Kvisby/ZPD_Kristaps_Bukss/Maketesanas_plate/20240205_205620.jpg

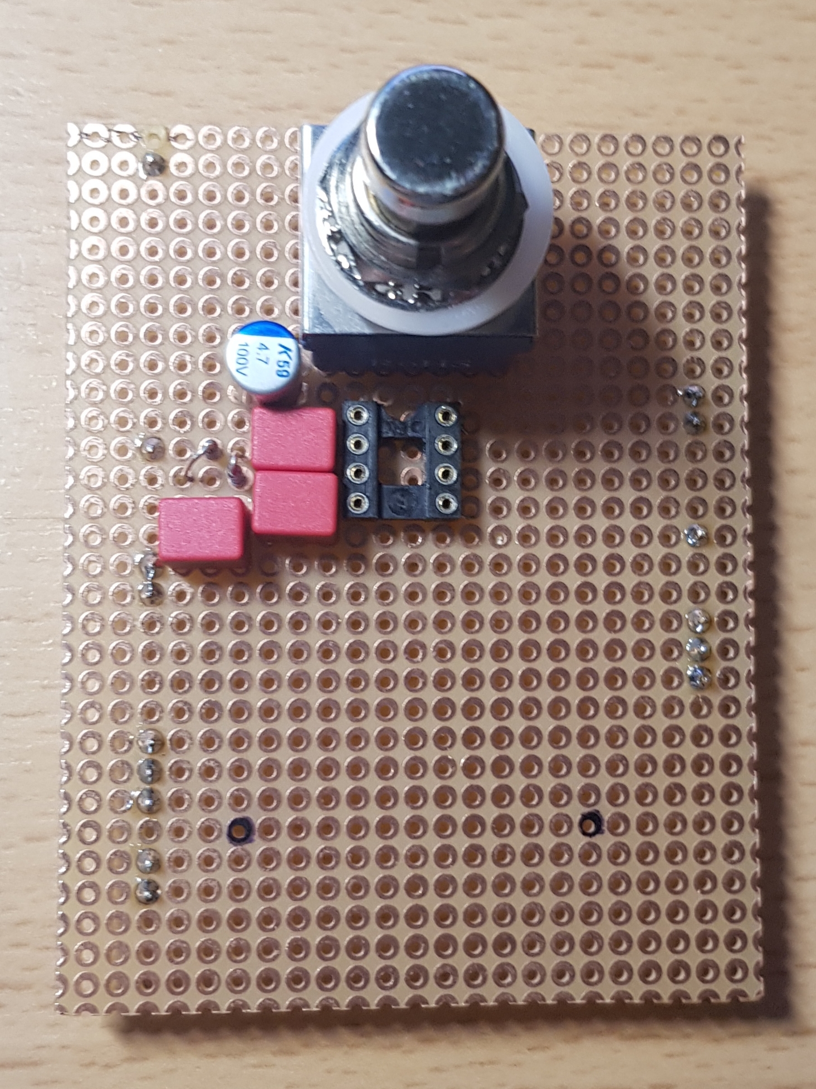
Maketesanas_plate/20240205_205620.jpg
