Kvisby/ZPD_Kristaps_Bukss/Maketesanas_plate/20240205_205634.jpg

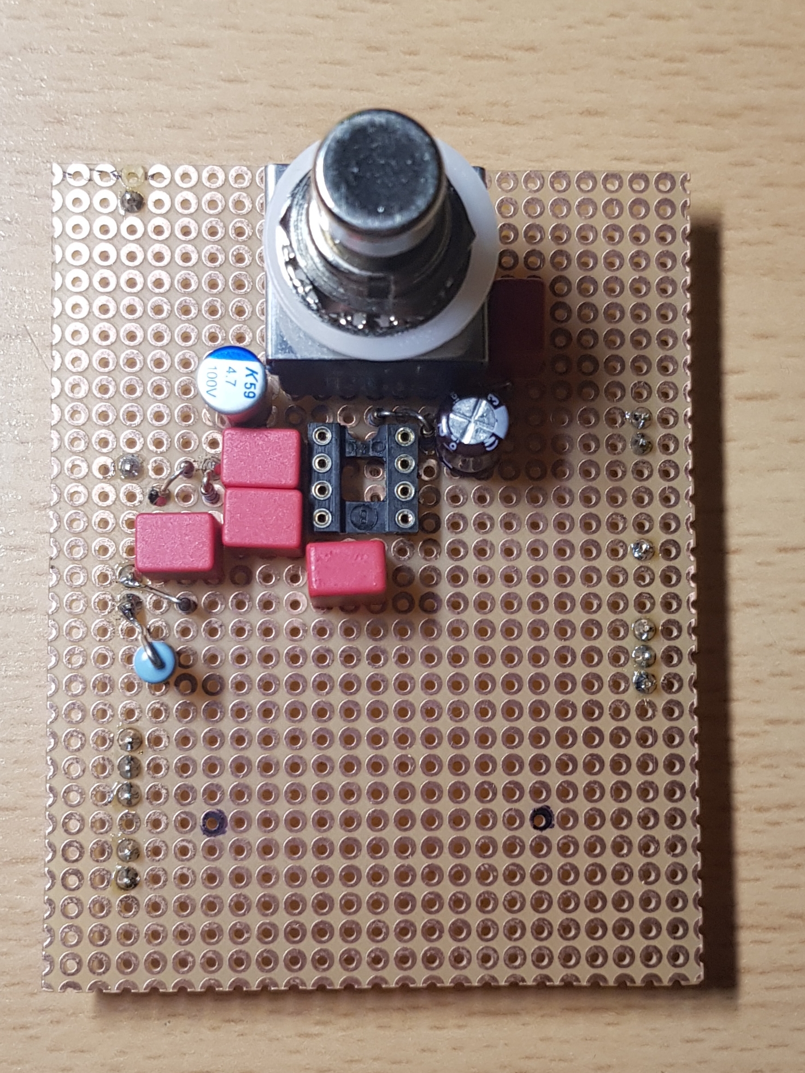
Maketesanas_plate/20240205_205634.jpg
