Kvisby/ZPD_Kristaps_Bukss/README.md

# ZPD_Kristaps_Bukss
Izmantotie/svarīgie faili zpd izveidei (Drukatas_plates_shema_ZPD_KB.json un Grafiskas_plates_shema_ZPD_KB faili jāatver caur "EasyEDA" programmu)
