Kvisby/ZPD_Kristaps_Bukss/Komponentes/1MΩ.jpg

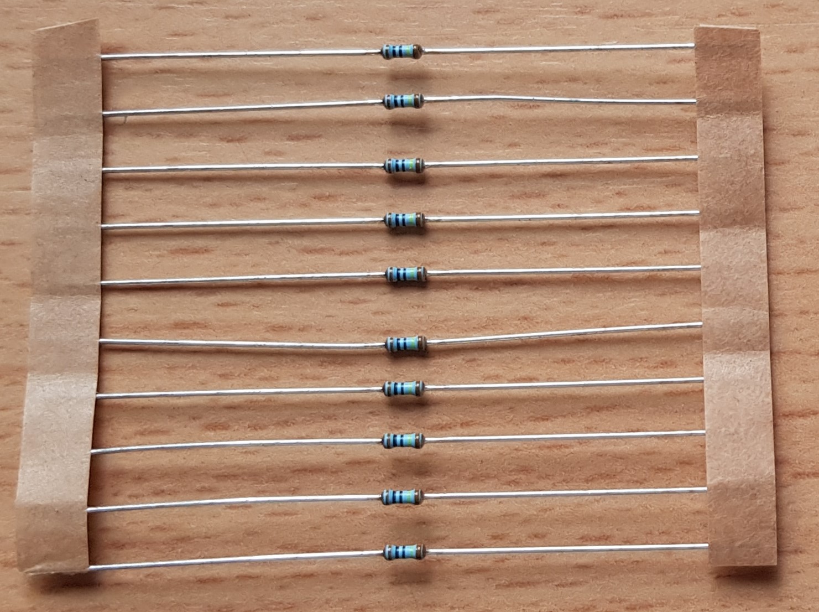
Komponentes/1MΩ.jpg
