Kvisby/ZPD_Kristaps_Bukss/Komponentes/2MΩ.jpg

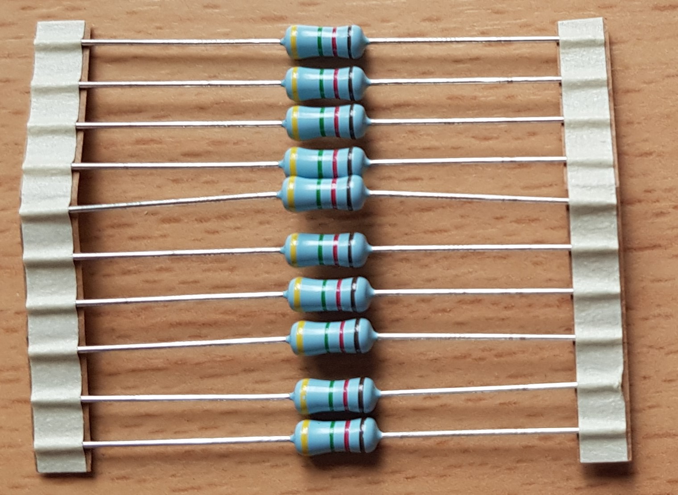
Komponentes/2MΩ.jpg
