Kvisby/ZPD_Kristaps_Bukss/Komponentes/4.7uF.jpg

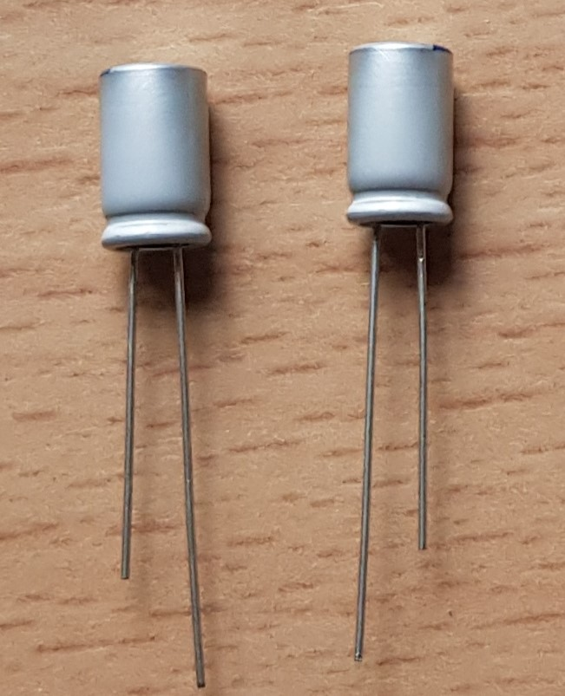
Komponentes/4.7uF.jpg
