Kvisby/ZPD_Kristaps_Bukss/Komponentes/6.8nF.jpg

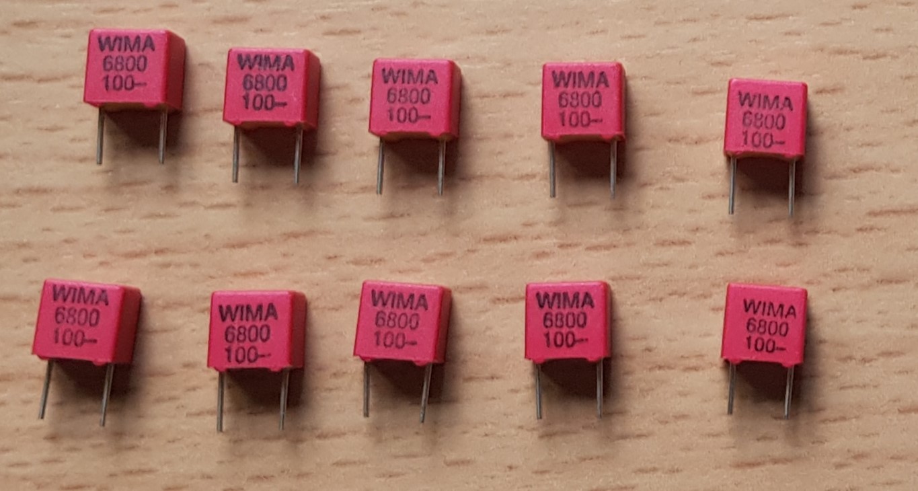
Komponentes/6.8nF.jpg
