Kvisby/ZPD_Kristaps_Bukss/Komponentes/7kΩ.jpg

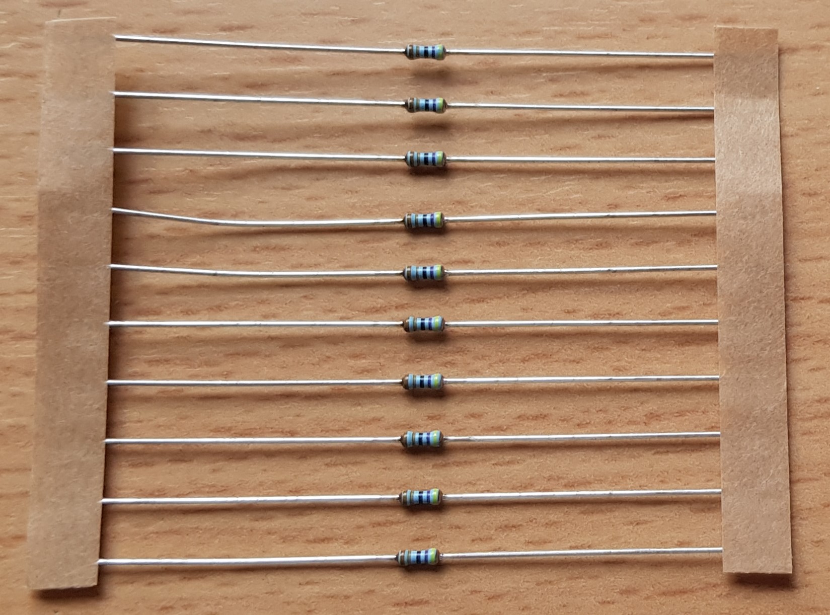
Komponentes/7kΩ.jpg
