Kvisby/ZPD_Kristaps_Bukss/Komponentes/100kΩ.jpg

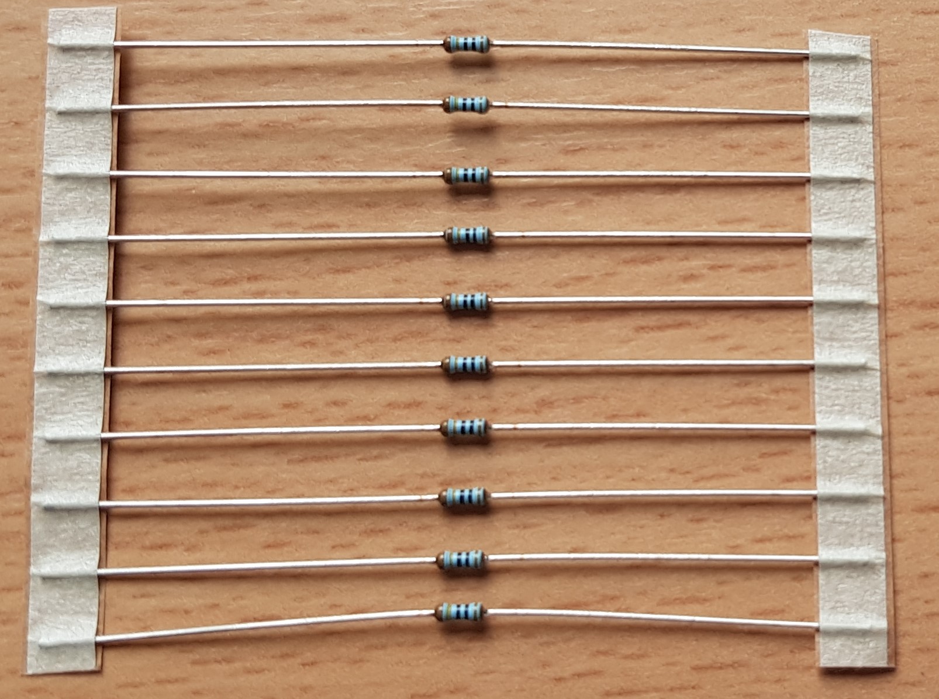
Komponentes/100kΩ.jpg
