Kvisby/ZPD_Kristaps_Bukss/Komponentes/100nF.jpg

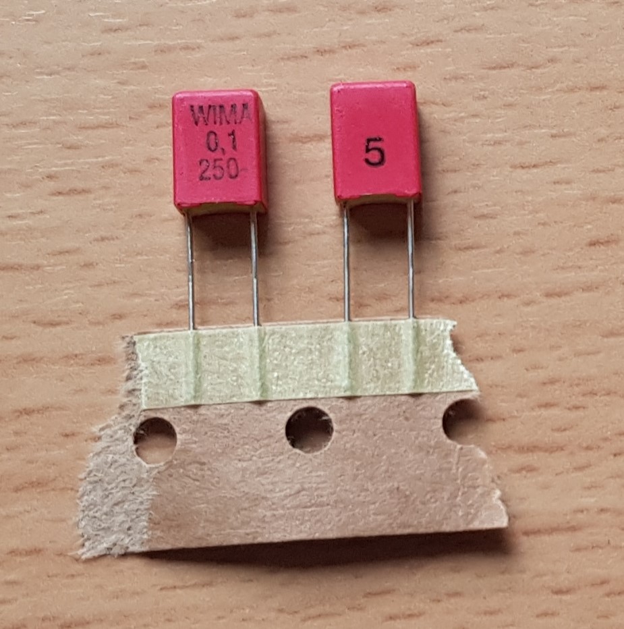
Komponentes/100nF.jpg
