Kvisby/ZPD_Kristaps_Bukss/Komponentes/20240204_141854.jpg

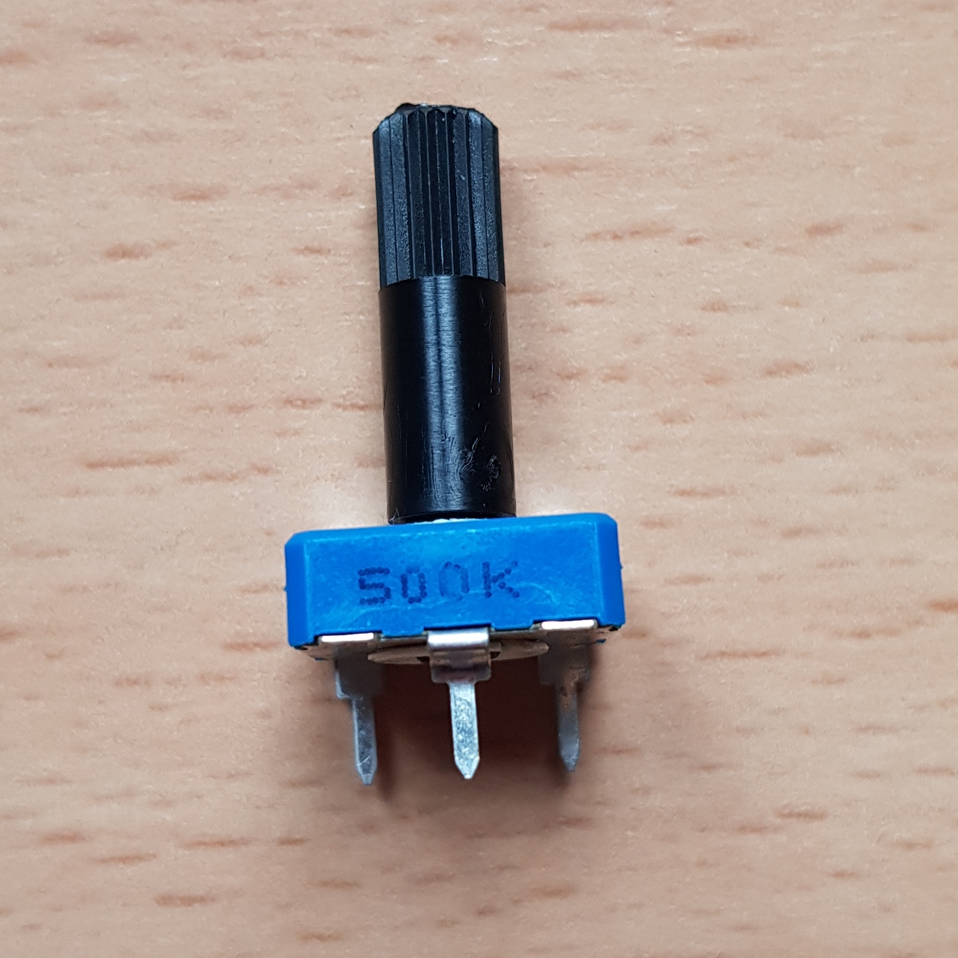
Komponentes/20240204_141854.jpg
