Kvisby/ZPD_Kristaps_Bukss/Komponentes/20240204_141914.jpg

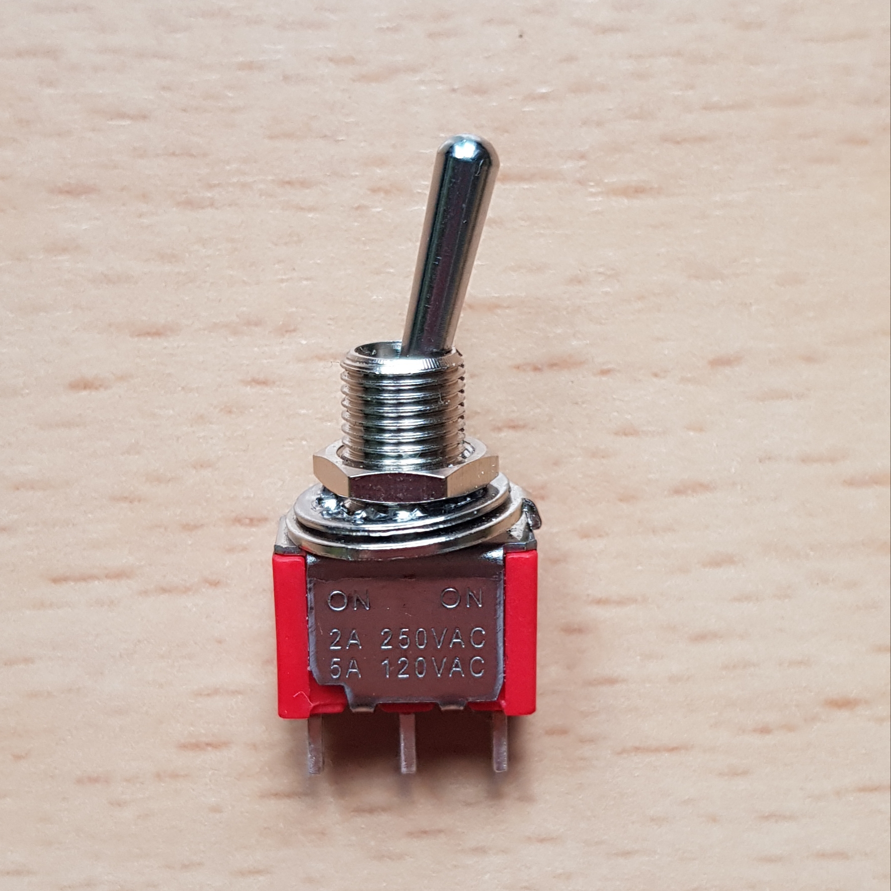
Komponentes/20240204_141914.jpg
