Kvisby/ZPD_Kristaps_Bukss/Komponentes/20240204_141937.jpg

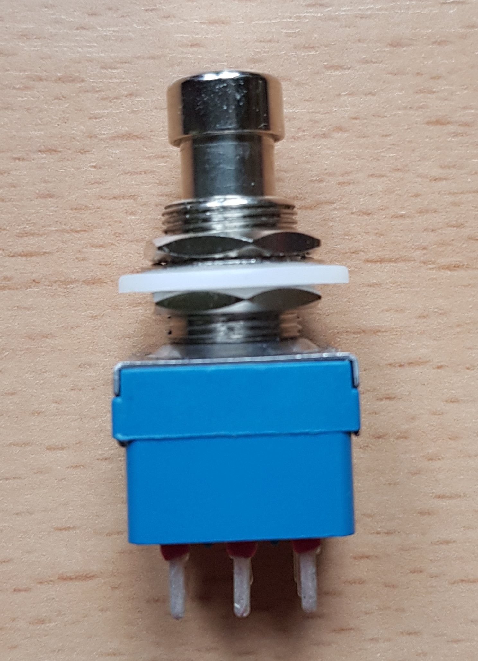
Komponentes/20240204_141937.jpg
