Kvisby/ZPD_Kristaps_Bukss/Komponentes/20240204_142005.jpg

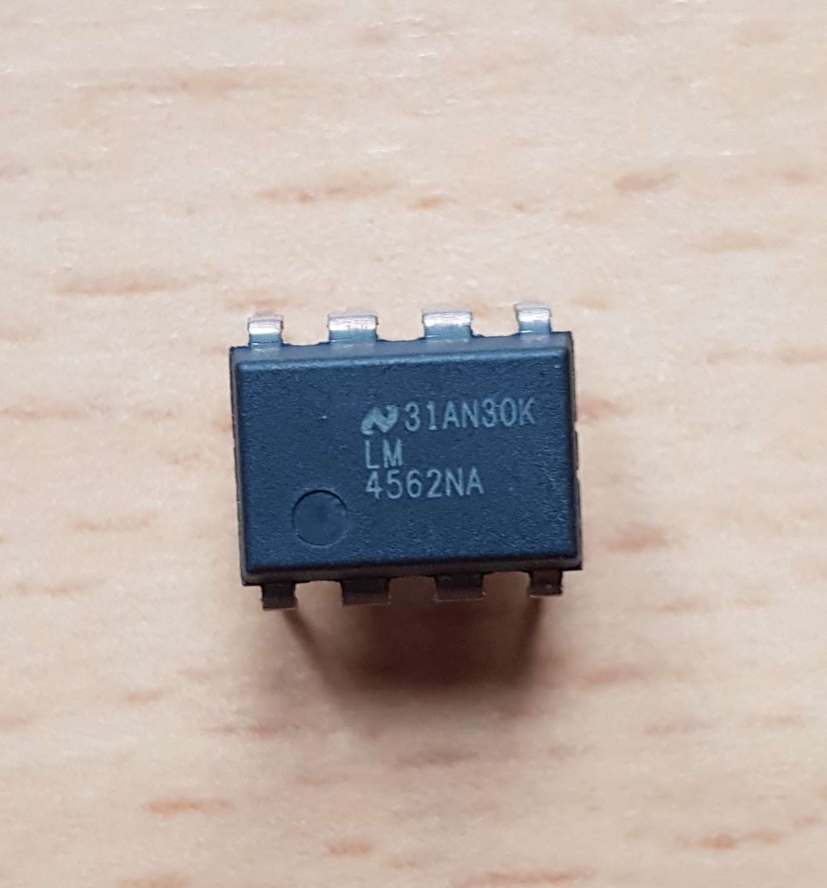
Komponentes/20240204_142005.jpg
