Kvisby/ZPD_Kristaps_Bukss/Komponentes/20240204_142020.jpg

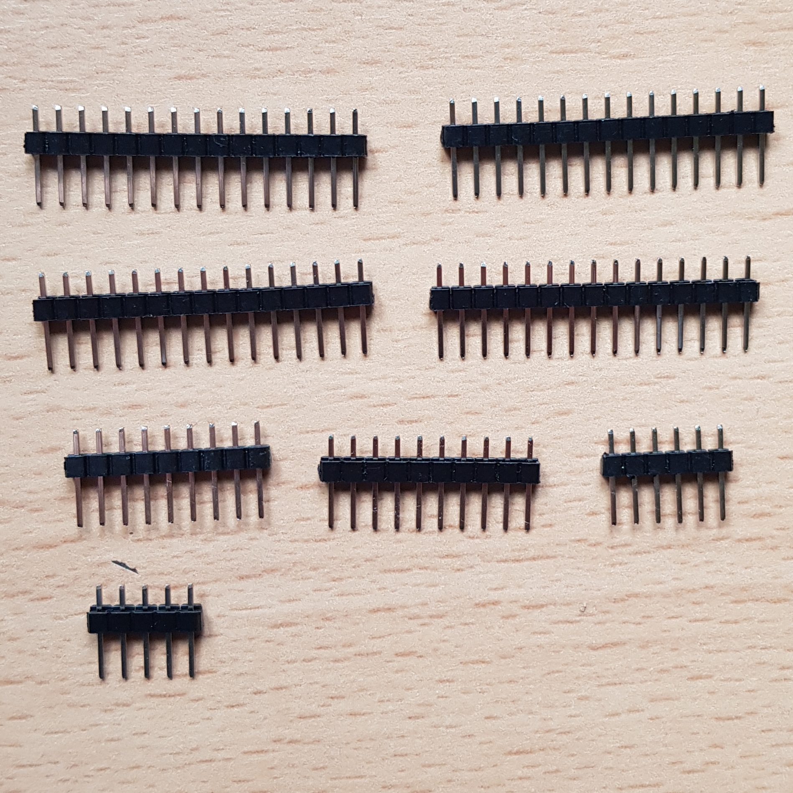
Komponentes/20240204_142020.jpg
