Kvisby/ZPD_Kristaps_Bukss/Komponentes/20240204_142149.jpg

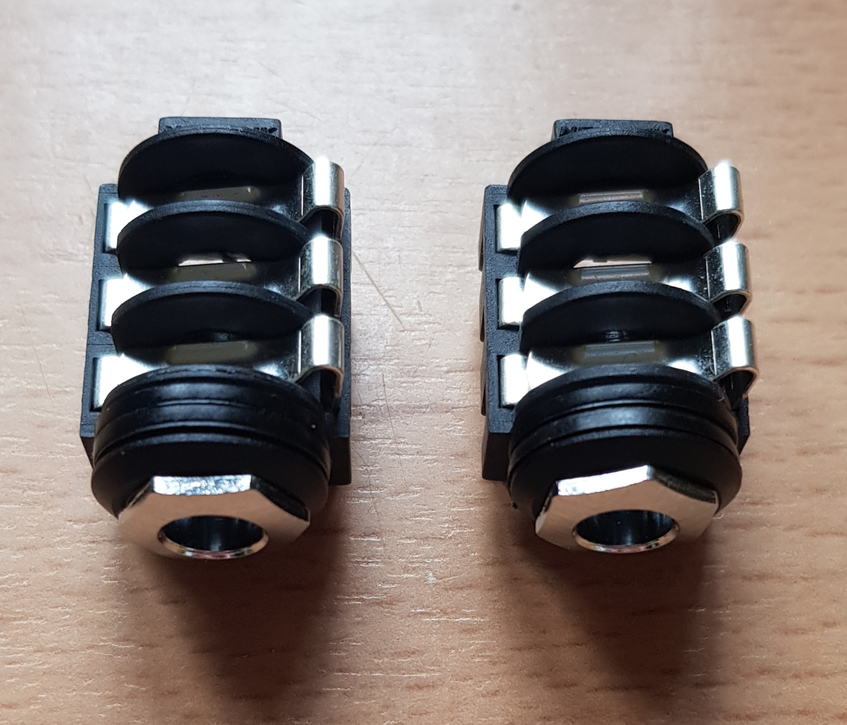
Komponentes/20240204_142149.jpg
