Kvisby/ZPD_Kristaps_Bukss/Komponentes/20240204_142242.jpg

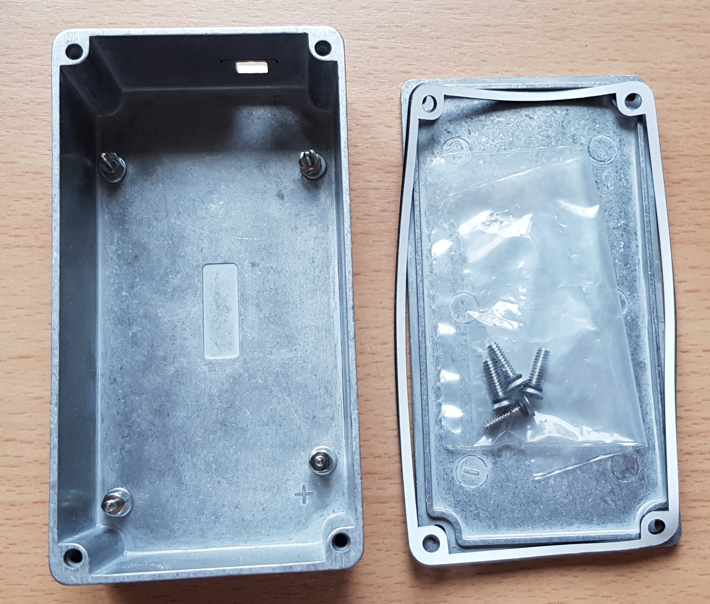
Komponentes/20240204_142242.jpg
