Kvisby/ZPD_Kristaps_Bukss/Komponentes/20240204_142527.jpg

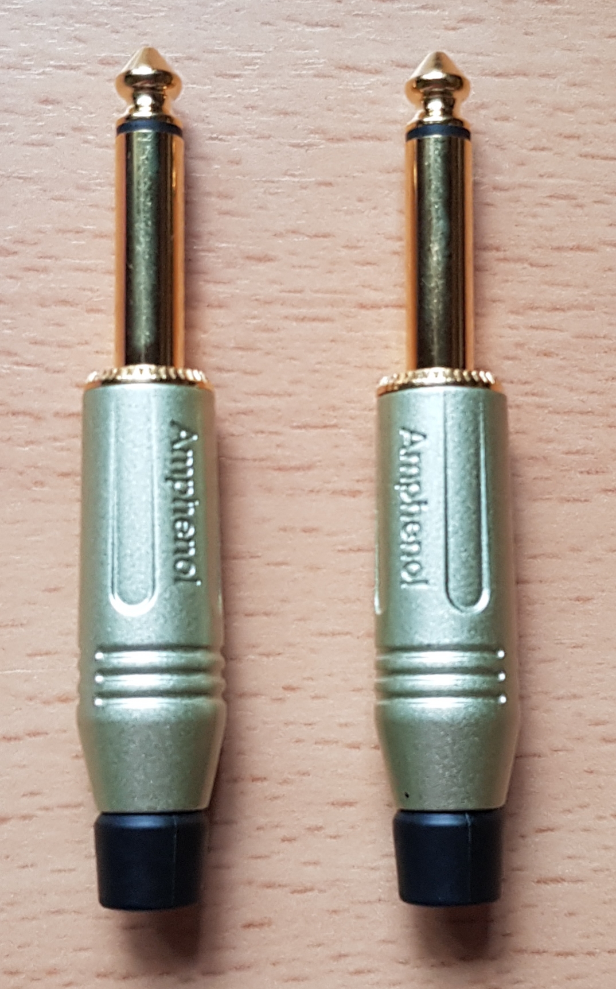
Komponentes/20240204_142527.jpg
