Kvisby/ZPD_Kristaps_Bukss/Komponentes/20240210_181315.jpg

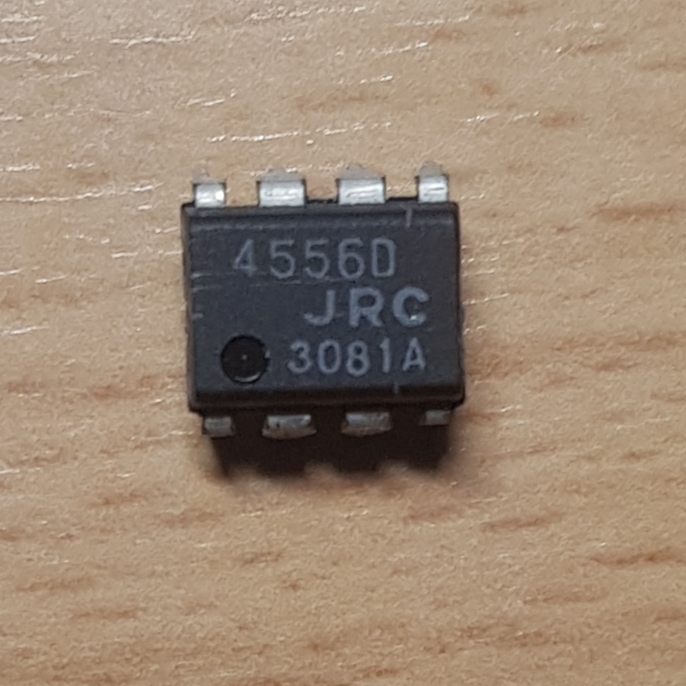
Komponentes/20240210_181315.jpg
