Kvisby/ZPD_Kristaps_Bukss/Komponentes/Arduino Mega.jpg

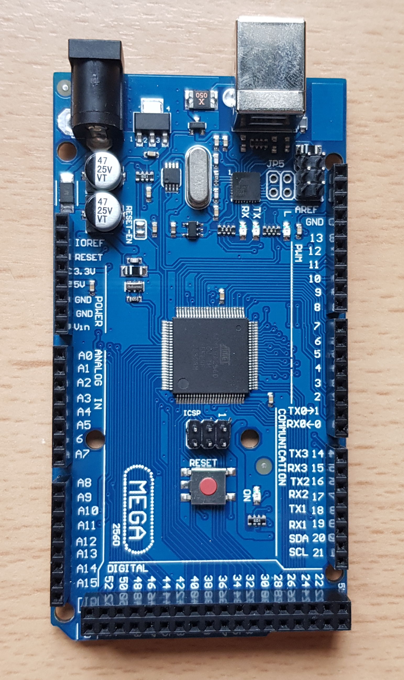
Komponentes/Arduino Mega.jpg
