Kvisby/ZPD_Kristaps_Bukss/Komponentes/OLED display.jpg

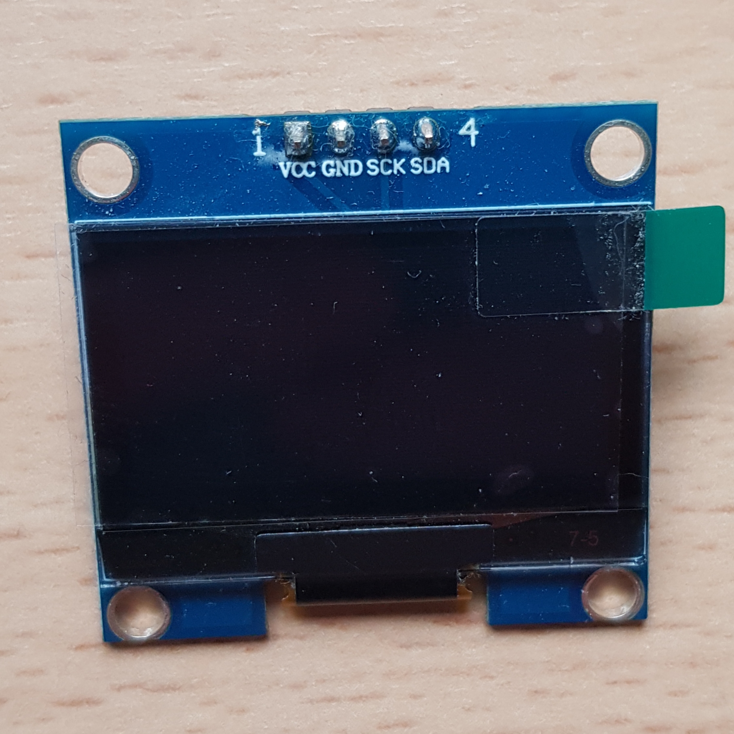
Komponentes/OLED display.jpg
