Kvisby/ZPD_Kristaps_Bukss/Korpuss/20240204_142343.jpg

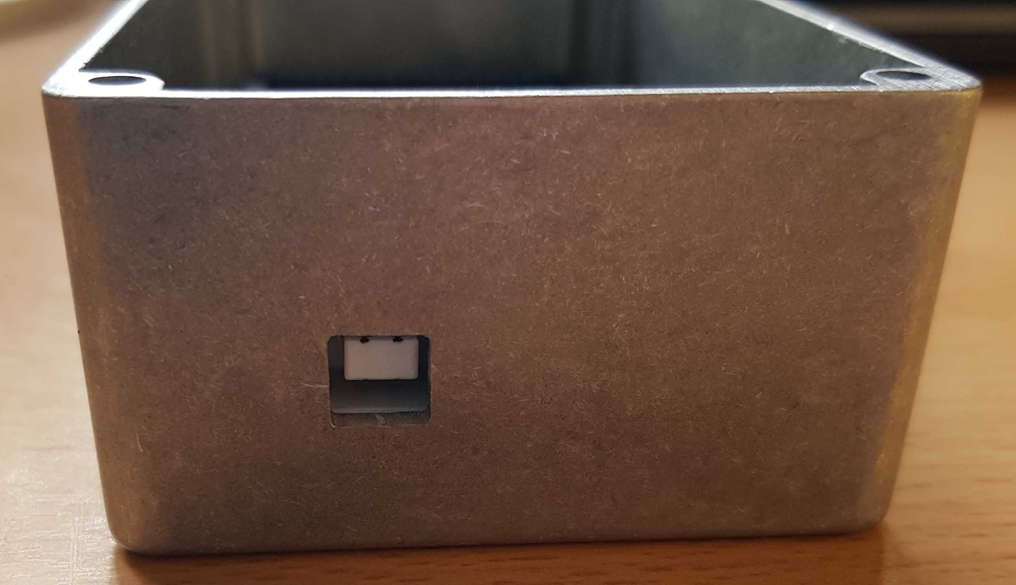
Korpuss/20240204_142343.jpg
