Kvisby/ZPD_Kristaps_Bukss/Korpuss/20240204_142431.jpg

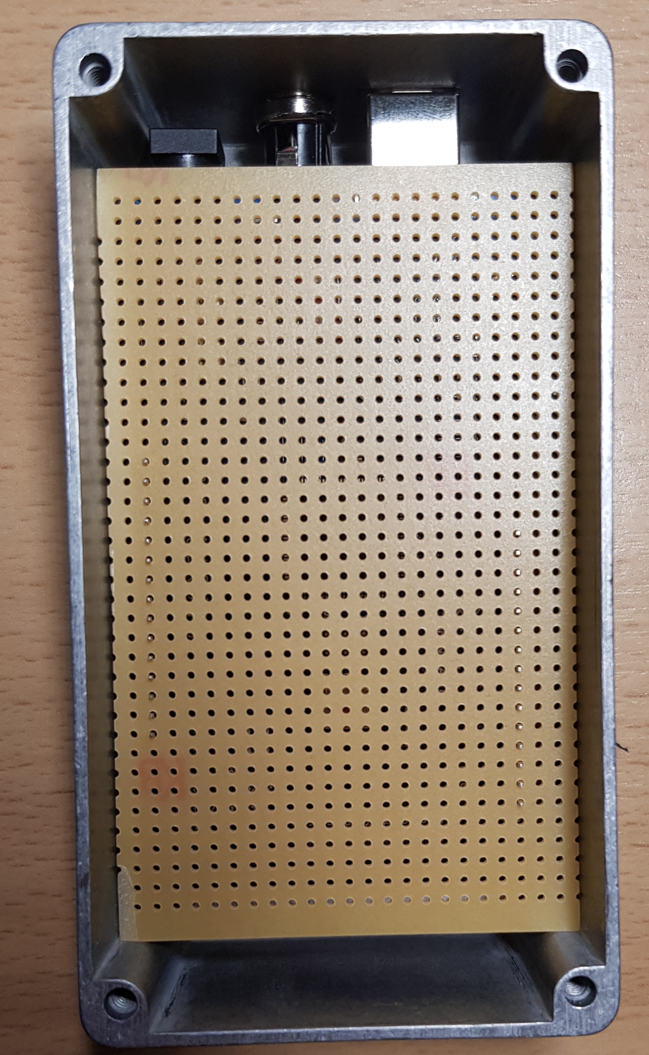
Korpuss/20240204_142431.jpg
