Kvisby/ZPD_Kristaps_Bukss/Kristaps_Bukss_grafiska_shema_ZPD.png

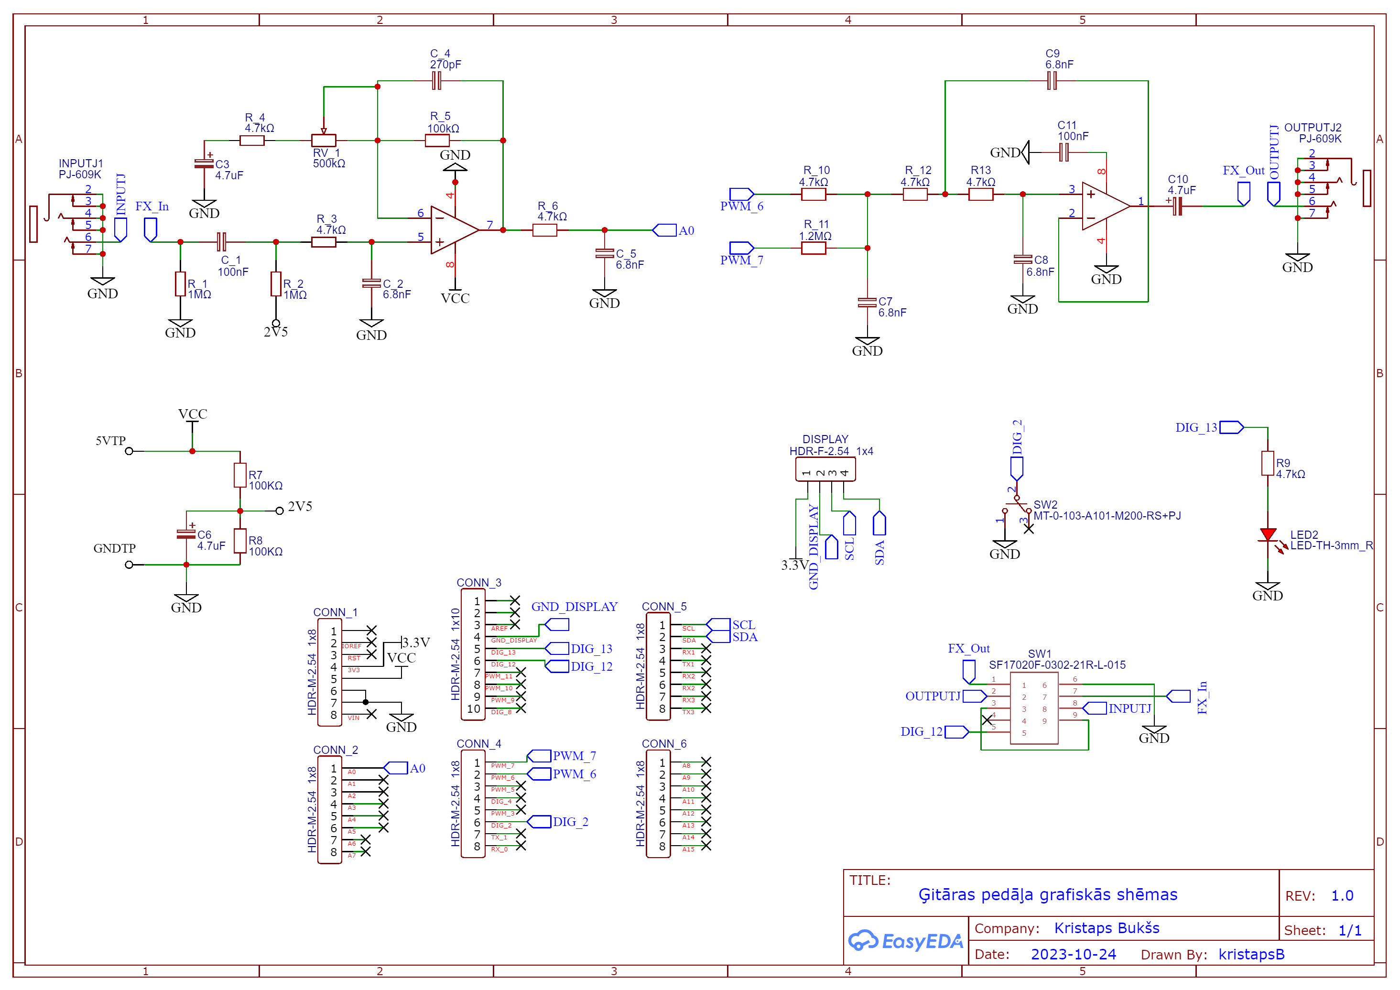
Kristaps_Bukss_grafiska_shema_ZPD.png
