Kvisby/ZPD_Kristaps_Bukss/Skopometrs_merijumi/20240211_124911.jpg

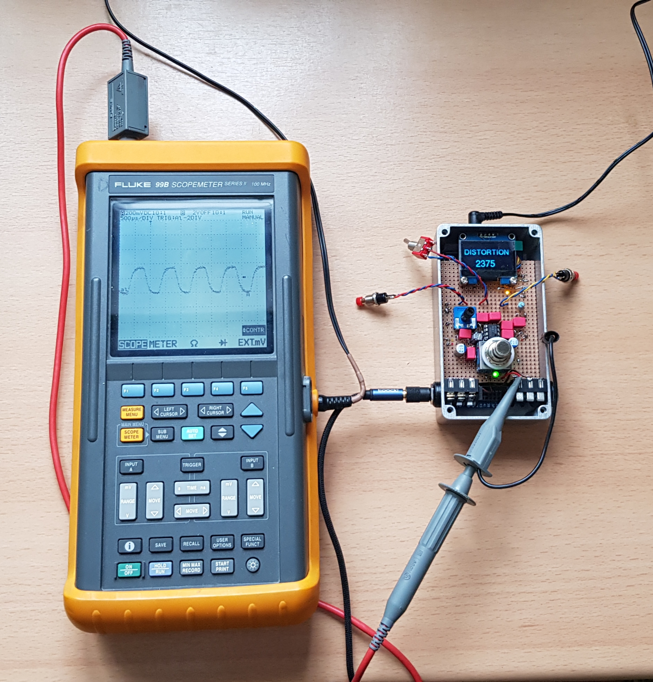
Skopometrs_merijumi/20240211_124911.jpg
