Kvisby/ZPD_Kristaps_Bukss/Skopometrs_merijumi/20240211_124943.jpg

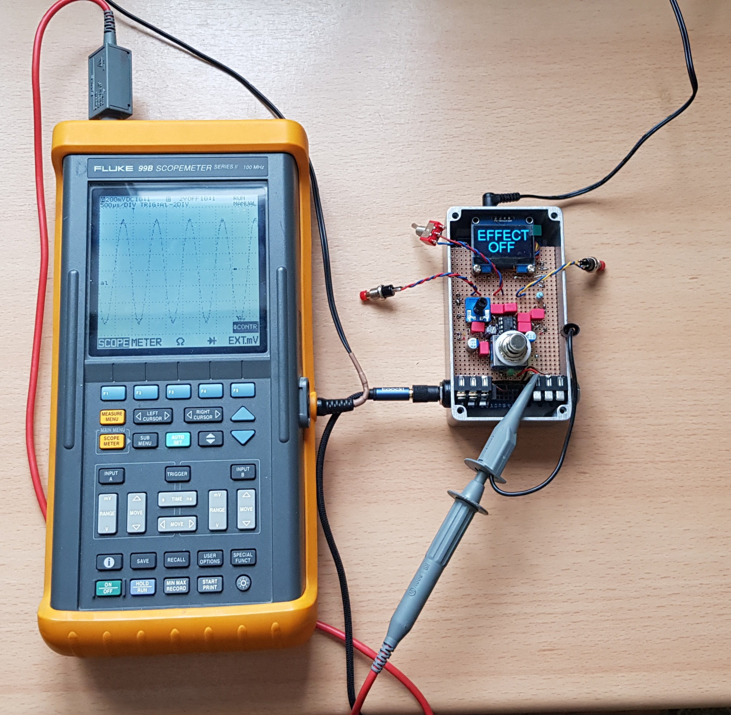
Skopometrs_merijumi/20240211_124943.jpg
