Kvisby/ZPD_Kristaps_Bukss/Skopometrs_merijumi/20240211_125319.jpg

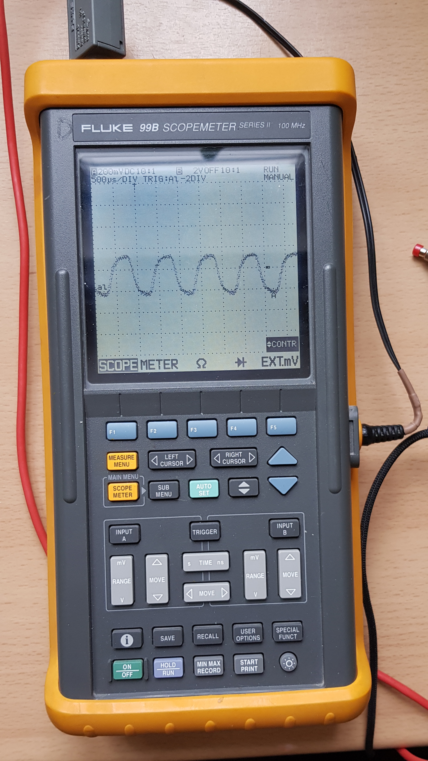
Skopometrs_merijumi/20240211_125319.jpg
