Kvisby/ZPD_Kristaps_Bukss/Skopometrs_merijumi/20240211_131904.jpg

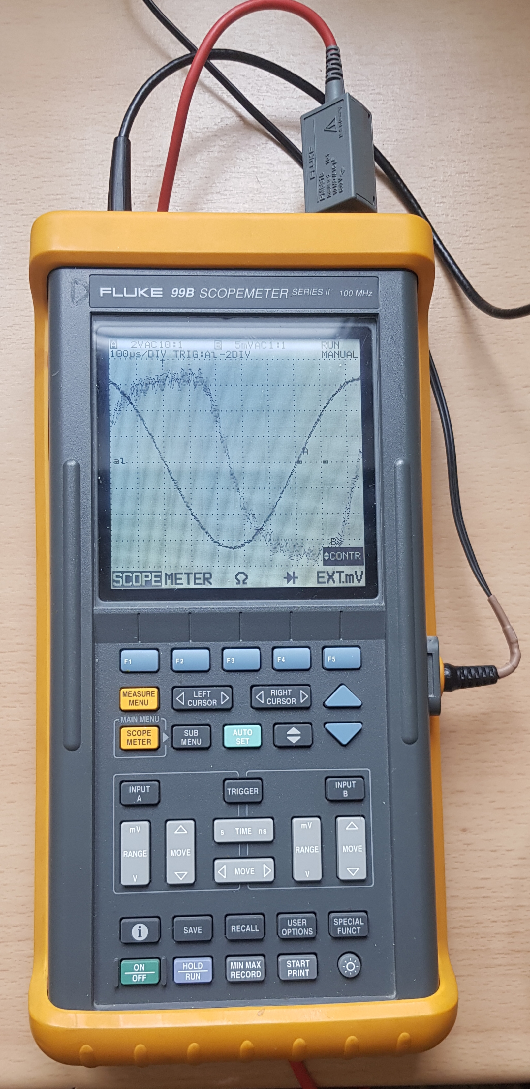
Skopometrs_merijumi/20240211_131904.jpg
